toffee/MyGasMeterX/hardware/BME280 timing and power.xlsx

osrs_t | 1 | may be 1,2,4,8,16
osrs_p | 0 | may be 1,2,4,8,16
osrs_h | 1 | may be 1,2,4,8,16
T_meas | 6 | ms
I DDSL | 0.1 | µA | sleep
I DDSB | 0.2 | µA | standby
I DDH | 340 | µA
I DDP | 714 | µA
I DDT | 350 | µA
ODR | 1 | Hz
C_meas | 2.2 | µA
 | 2200 | mAh
 | 994844.8946 | h
 | 41451.87061 | d
 | 113.5667688 | y
 | 9 | Bytes read
 | 4 | Bytes write
 | 100 | kHz
T_read | 1.04 | ms
