toffee/MyGasMeterX/hardware/Cext.xlsx

 |  |  | Source
Ce | 12 | pF
Ci | 6 | pF
Cs | 2 | pF
CL | 10 | pF | Reichelt datasheet
 | Formula |  | Microchip AN2519
