toffee/MyGasMeterX/pictures/HABpanel.png

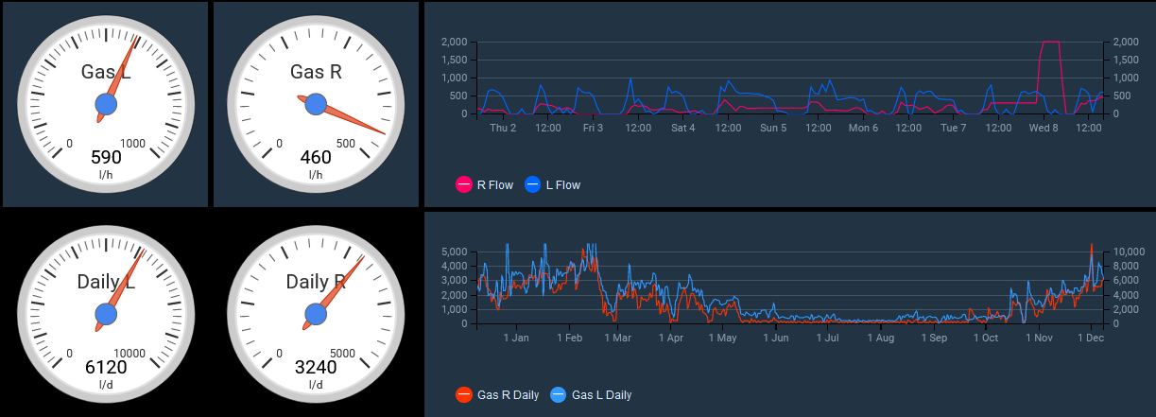
pictures/HABpanel.png
