toffee/MyGasMeterX/pictures/MyGasMeterX lg detail.jpg

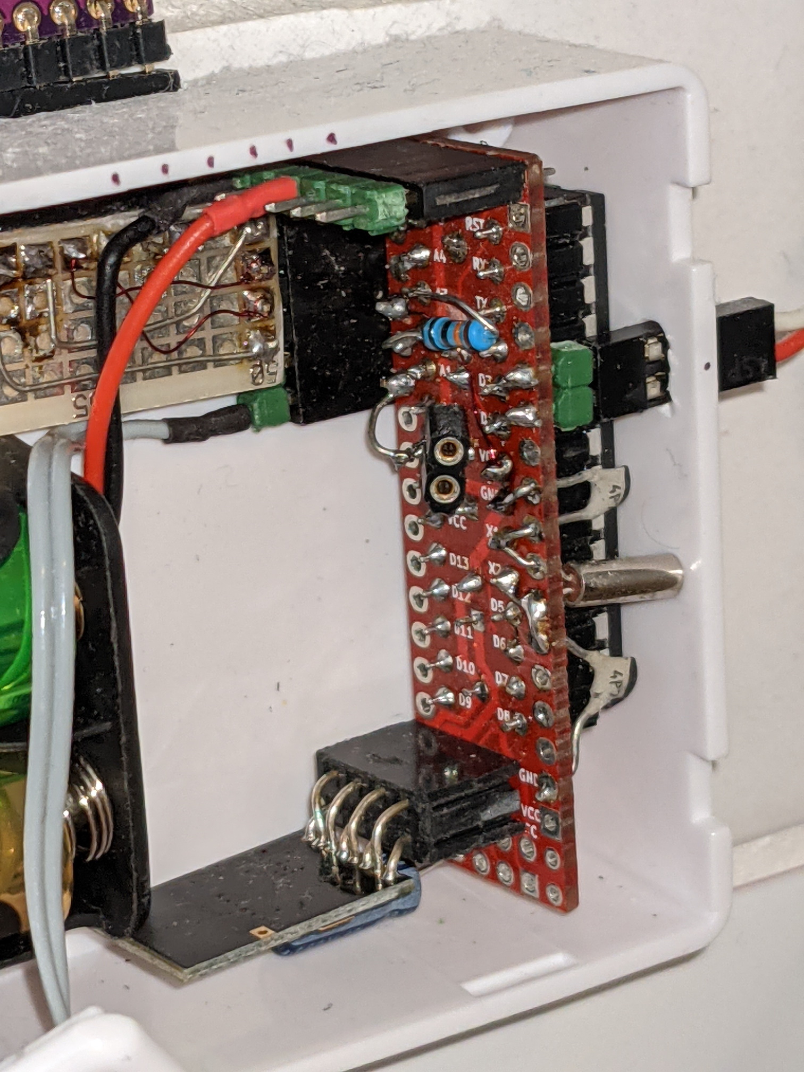
pictures/MyGasMeterX lg detail.jpg
