toffee/MyGasMeterX/pictures/MyGasMeterX sm detail.jpg

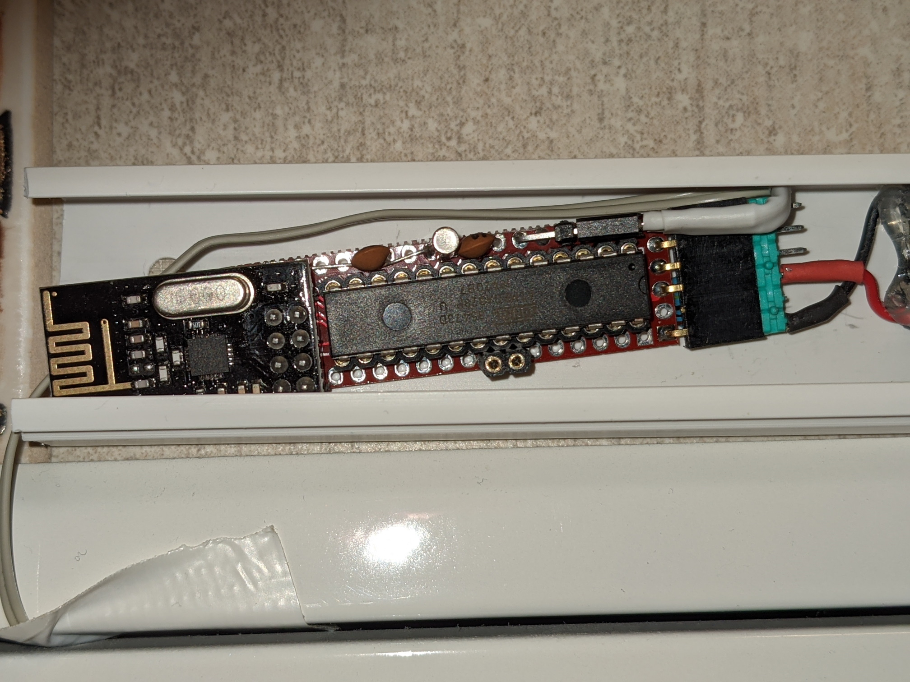
pictures/MyGasMeterX sm detail.jpg
