toffee/MyGasMeterX/hardware/BOM MyGasMeter.xlsx

large
 |  |  |  |  | 7.22 €
amount | description | cost/lot | pcs/lot | cost/piece | cost | reference
1 | White DYI case |  |  | 0.91 € | 0.91 €
1 | Battery holder 2xAA |  |  | 0.26 € | 0.26 €
1 | Slim PCB Module | 2.23 € | 1 | 2.23 € | 2.23 € | http://dirtypcbs.com/store/designer/details/m26872/663/myslim2aabatterynodepcbv2-0panelized
1 | NRF24L01+ module |  |  | 0.75 € | 0.75 €
1 | GY-BME280-3.3 |  |  | 1.87 € | 1.87 € | https://www.aliexpress.com/item/32862421810.html
1 | BPW40 |  |  | 0.29 € | 0.29 €
1 | Reed-Kontakt, 1 Schließer |  |  | 0.59 € | 0.59 € | Reichelt KSK 1A87
2 | capacitor 10pF |  |  | 0.06 € | 0.12 € | Reichelt KERKO 10P https://www.reichelt.de/keramik-kondensator-10p-kerko-10p-p9268.html
1 | Watch crystal 32768 Hz |  |  | 0.20 € | 0.20 € | Reichelt 0,032768 https://www.reichelt.de/mini-uhrenquarz-0-032768-mhz-tc38-0-032768-p1089.html
small
 |  |  |  |  | 4.38 €
amount | description | cost/lot | pcs/lot | cost/piece | cost | reference
1 | White cable duct | 14.75 € | 65 | 0.23 € | 0.23 € | https://www.amazon.de/gp/product/B01N2ZYC3B
1 | Battery holder 2xAA |  |  | 0.26 € | 0.26 €
1 | Slim PCB Module | 2.23 € | 1 | 2.23 € | 2.23 € | http://dirtypcbs.com/store/designer/details/m26872/663/myslim2aabatterynodepcbv2-0panelized
1 | NRF24L01+ module |  |  | 0.75 € | 0.75 €
1 | Reed-Kontakt, 1 Schließer |  |  | 0.59 € | 0.59 € | Reichelt KSK 1A87
2 | capacitor 10pF |  |  | 0.06 € | 0.12 € | Reichelt KERKO 10P https://www.reichelt.de/keramik-kondensator-10p-kerko-10p-p9268.html
1 | Watch crystal 32768 Hz |  |  | 0.20 € | 0.20 € | Reichelt 0,032768 https://www.reichelt.de/mini-uhrenquarz-0-032768-mhz-tc38-0-032768-p1089.html
