toffee/MyGasMeterX/hardware/MyGasMeterX.pdf

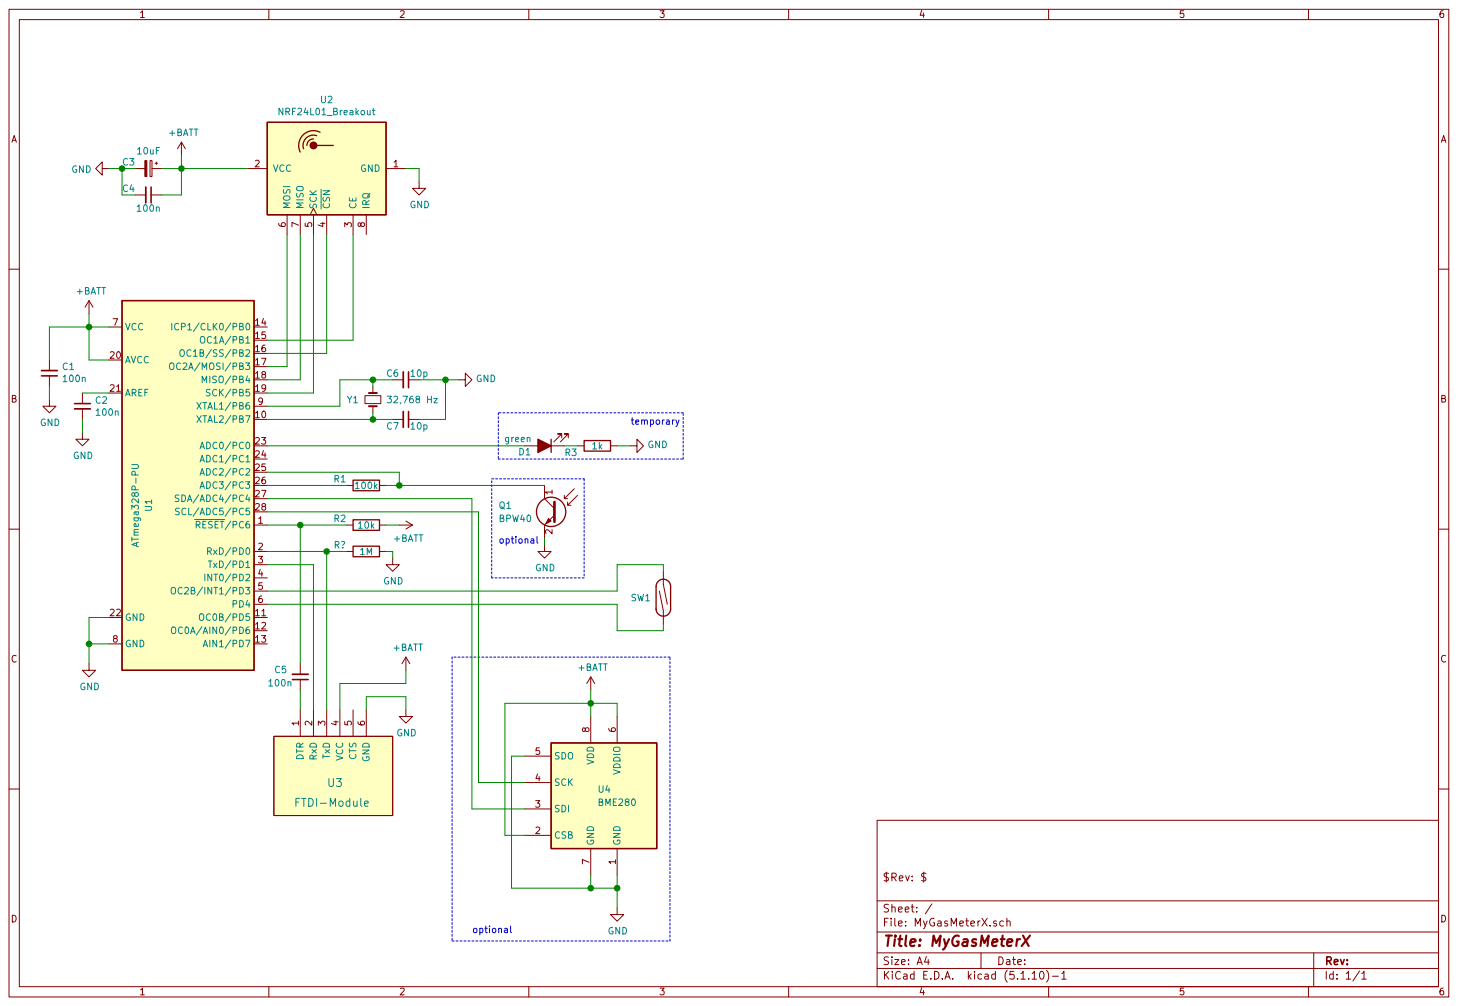
[picture p9: page 1]

File: MyGasMeterX.sch Sheet: / $Rev: $ GND GND
