toffee/MyGasMeterX/(commit log)

2021-12-11 fixed: err msg re missing function w/ BME280 lib
    [MyGasMeterX.cpp]
2022-01-05 fix: didn't set transportSleeping after flow rept
    [MyGasMeterX.cpp]
